Budieh/Remote_Controlled_Tank/Caracteristica statica motor/Caracteristica statica a motorului.png

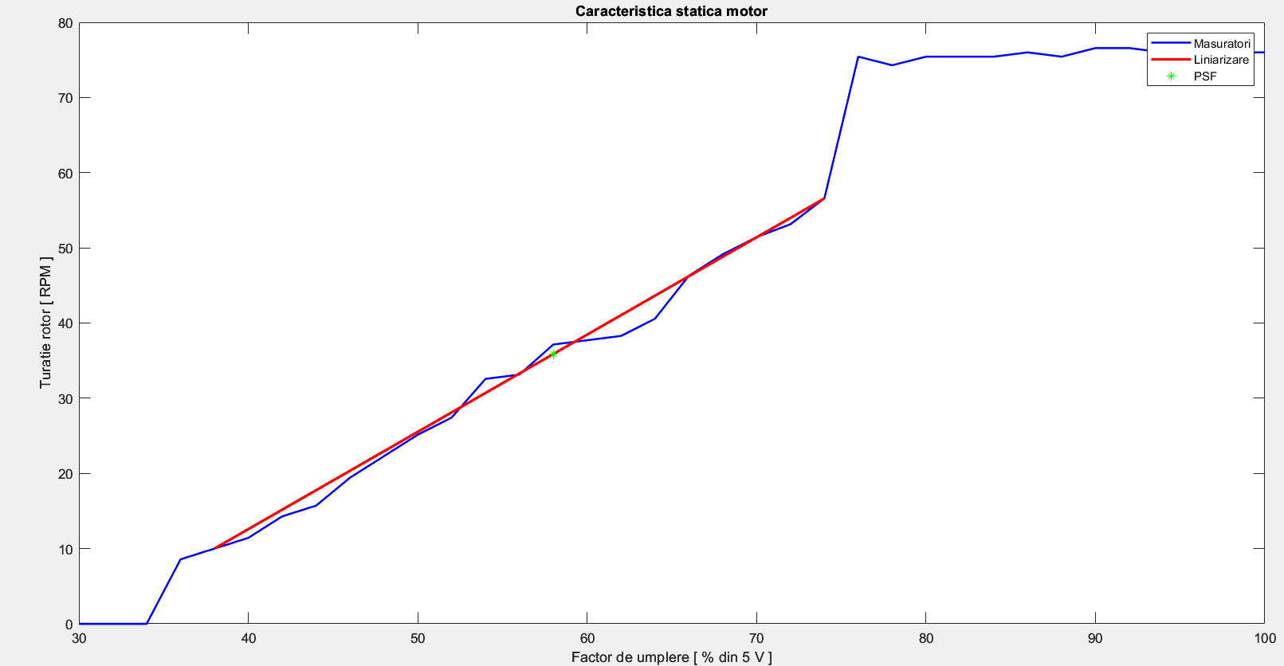
Caracteristica statica motor/Caracteristica statica a motorului.png
