Budieh/Remote_Controlled_Tank/Functie transfer motor/Raspunsul la treapta unitara al sistemului.png

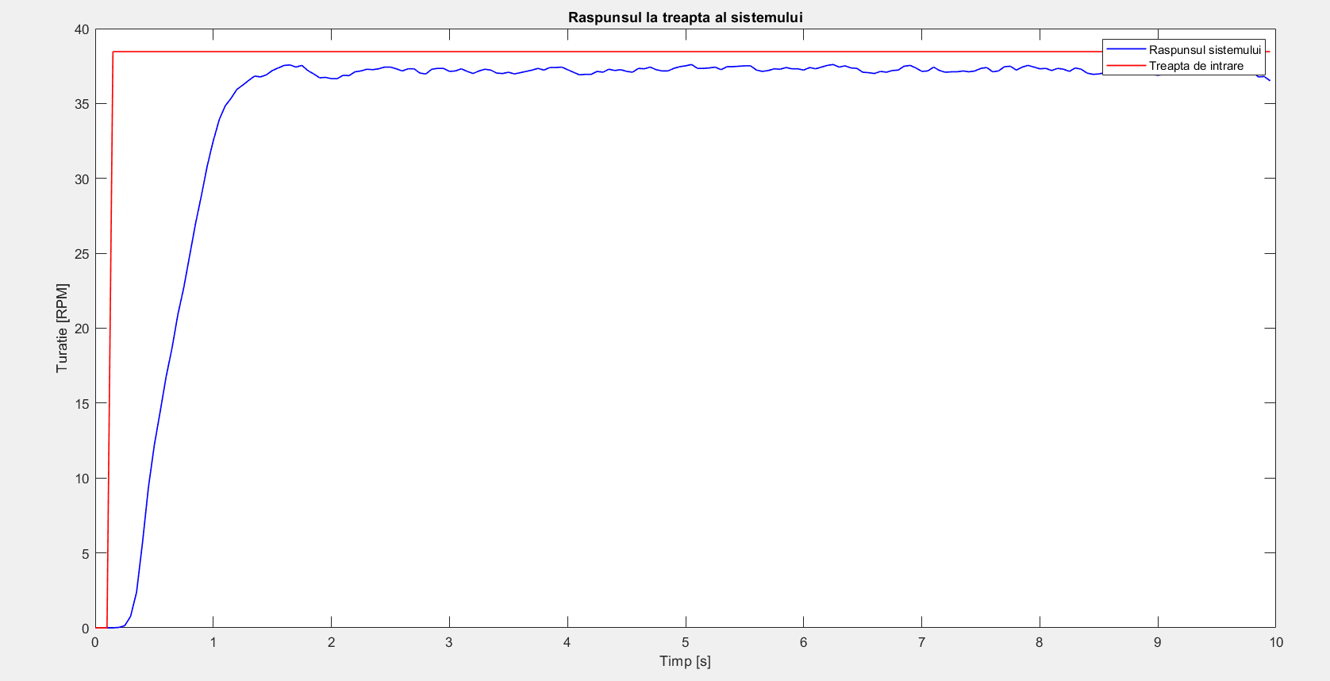
Functie transfer motor/Raspunsul la treapta unitara al sistemului.png
