Budieh/Remote_Controlled_Tank/Testare bucla inchisa/Raspuns sistem cu sarcina.png

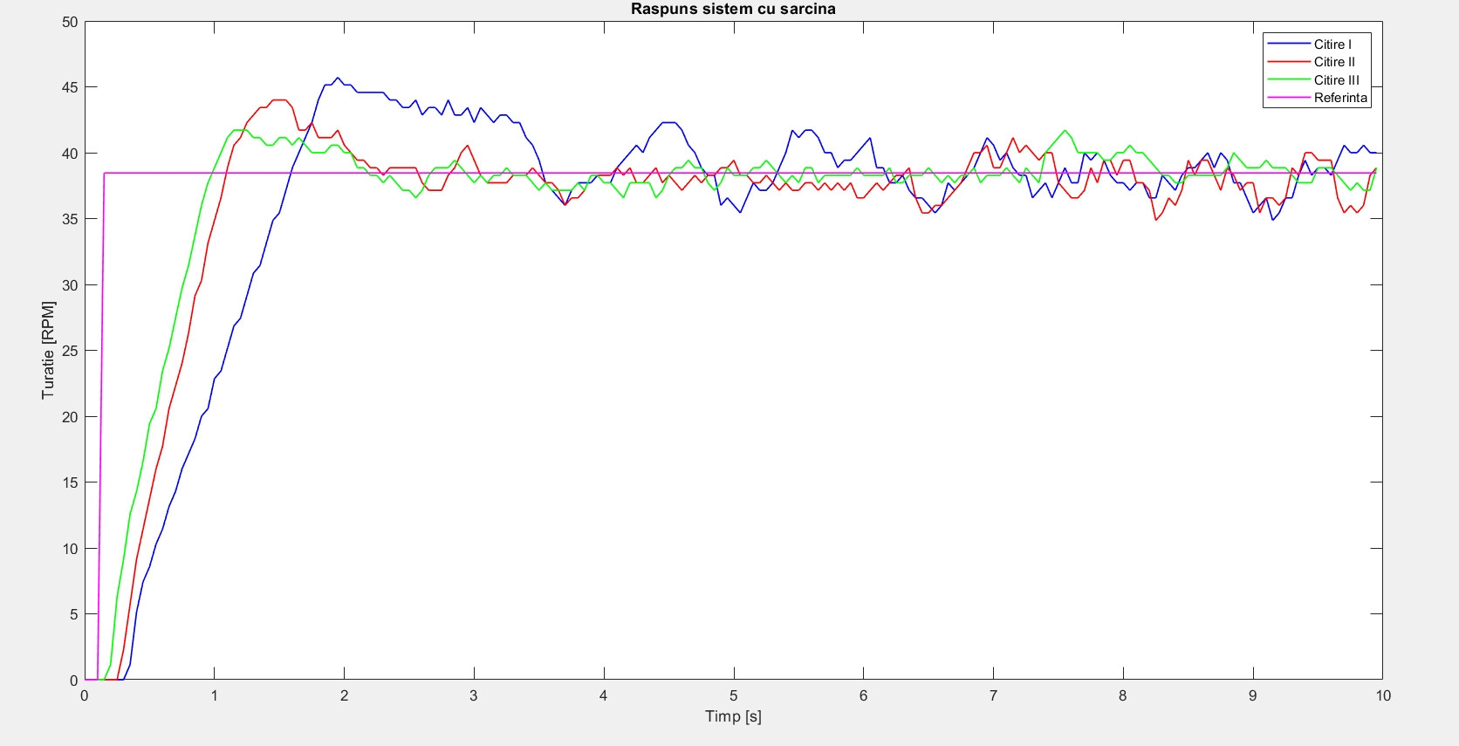
Testare bucla inchisa/Raspuns sistem cu sarcina.png
