Budieh/Remote_Controlled_Tank/Testare bucla inchisa/Raspuns sistem fara sarcina.png

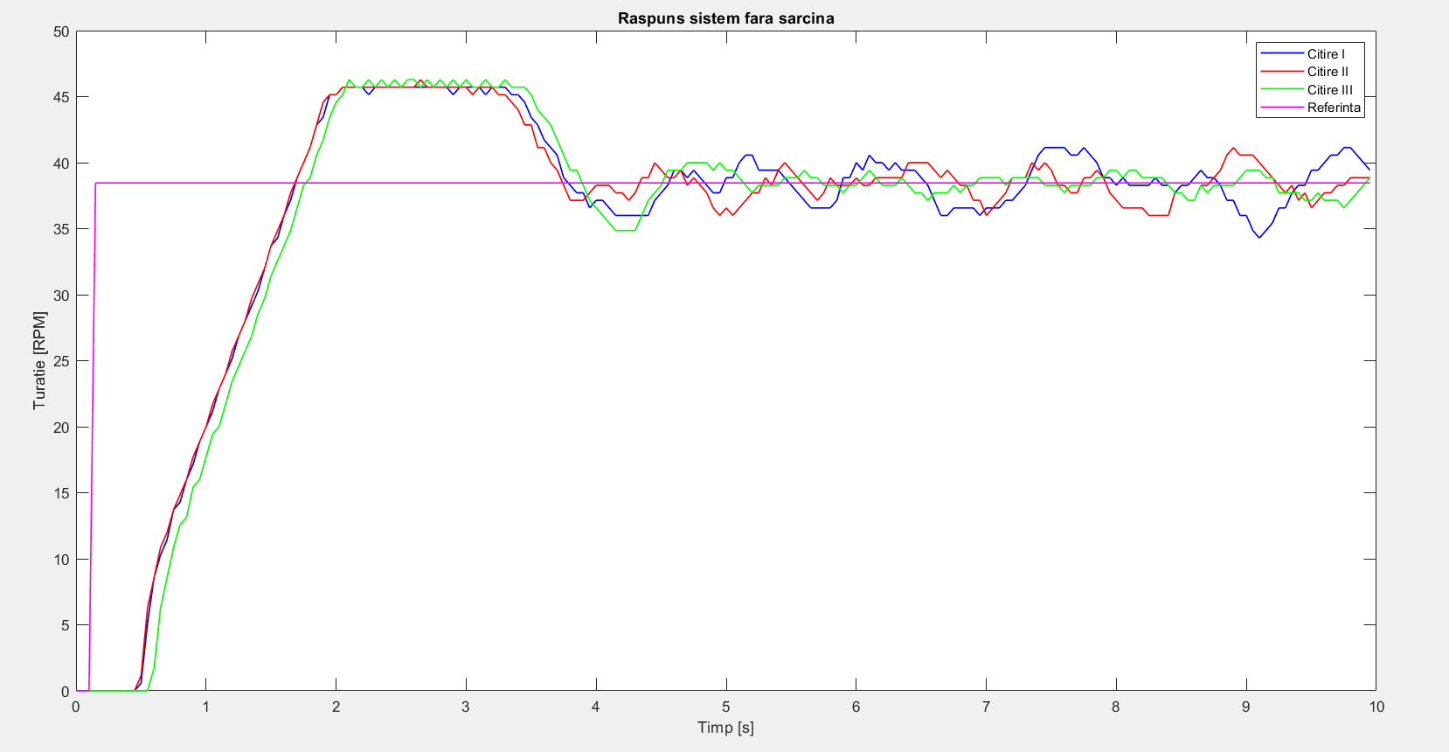
Testare bucla inchisa/Raspuns sistem fara sarcina.png
