Budieh/Remote_Controlled_Tank/LtSpice Models/LogicLevelConverter/LogicLevelConverter.asc

High: voltage; 5V
Low: voltage; 3.3V
Q1: npn; 2N2222
Q2: npn; 2N2222
R1: res; 1K
R2: res; 10K
R3: res; 1K
R4: res; 10K
Signal: voltage; PULSE(0 3.3 0 0 0 1 2)
Named nets: 0, High, Low, Signal, Output
.tran 10s
A simple logic level converter implemented using NPN BJTs. 
Required for controlling the motor drivers and the servomotor.
LtSpice directive for setting the simulation time at 10 seconds:
