Budieh/Remote_Controlled_Tank/LtSpice Models/RelayControlCircuit/RelayControlCircuit.asc

High: voltage; 5V
Low: voltage; 5V
Q1: npn; 2N2222
Q2: npn; 2N2222
Q3: npn; 2N2222
R1: res; 1K
R2: res; 10K
R3: res; 1K
R4: res; 10K
R5: res; 1K
R6: res; 10K
Signal: voltage; PULSE(0 3.3 0 0 0 1 2)
Named nets: 0, Signal, High, Output, Low, negOutput
.tran 10s
LtSpice directive for setting the simulation time at 10 seconds:
A simple circuit consisting of a logic level converter and a NOT gate.
Used for controlling a pair of relays that behave simmilar to an H bridge.
