Budieh/Remote_Controlled_Tank/LtSpice Models/VoltageRegulator/Voltage Regulator Model.asc

BVP3.3: schottky
BVP5: schottky
Cadj3.3: cap; 10µF
Cadj5: cap; 10µF
Cin3.3: cap; 150µF
Cin5: cap; 150µF
Cout3.3: cap; 150µF
Cout5: cap; 150µF
R1_3.3: res; 100
R1_5: res; 100
R2_3.3: res; 164
R2_5: res; 300
Regulator3.3: LT1117
Regulator5: LT1117
Source: voltage; 9V
Named nets: Cout3.3, 0, Source, Out5
.tran 10
LtSpice directive for setting the simulation time at 10 seconds:
Voltage regulators based on the LT1117 regulator used for obtaining stable 3.3V and 5V output lines that
can deliver up to 800 mA of current.
Please note that, due to output current limitations ( up to 3A instead of 800 mA ) and part availability
I chose to use the LM2576T-ADJ regulator for the implementation of this voltage regulator.
There are 2 main differences:
1) the regulator has 2 extra pins: GND and ENABLE ( active low ), both of which have to be connected
to ground.
2) The values of R1 and R2 have to be changed to 1K ohms and, respectively, 1.64K ohms for the 
3.3V line and 3K ohms for the 5V line ( 1.7K ohms works too for the 3.3V line, for convenience purposes).
