Budieh/Remote_Controlled_Tank/Proiect Platforma_test_motor/Core/Inc/main.h

#define B1_Pin GPIO_PIN_13
#define B1_GPIO_Port GPIOC
#define B1_EXTI_IRQn EXTI4_15_IRQn
#define RCC_OSC32_IN_Pin GPIO_PIN_14
#define RCC_OSC32_IN_GPIO_Port GPIOC
#define RCC_OSC32_OUT_Pin GPIO_PIN_15
#define RCC_OSC32_OUT_GPIO_Port GPIOC
#define RCC_OSC_IN_Pin GPIO_PIN_0
#define RCC_OSC_IN_GPIO_Port GPIOF
#define RCC_OSC_OUT_Pin GPIO_PIN_1
#define RCC_OSC_OUT_GPIO_Port GPIOF
#define USART_TX_Pin GPIO_PIN_2
#define USART_TX_GPIO_Port GPIOA
#define USART_RX_Pin GPIO_PIN_3
#define USART_RX_GPIO_Port GPIOA
#define LD2_Pin GPIO_PIN_5
#define LD2_GPIO_Port GPIOA
#define TMS_Pin GPIO_PIN_13
#define TMS_GPIO_Port GPIOA
#define TCK_Pin GPIO_PIN_14
#define TCK_GPIO_Port GPIOA
